ashleyxchen/echo-project/README.md

# echo-project

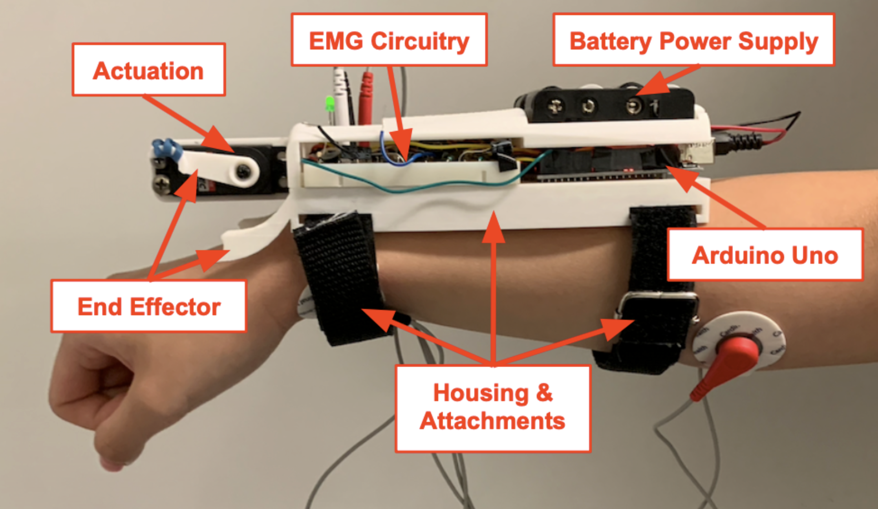
[picture p1: Figures and Tables/IMG_1434.png]

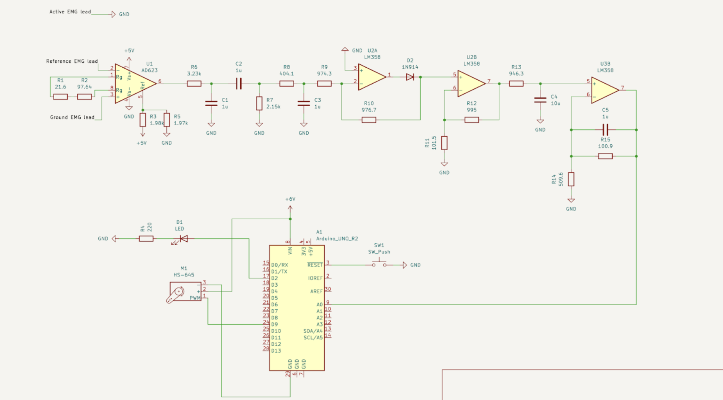
[picture p2: Figures and Tables/IMG_4543.png]

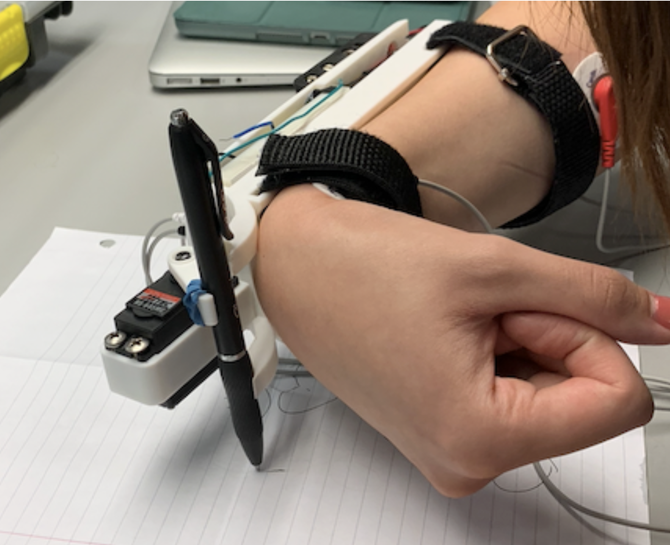
[picture p3: Figures and Tables/IMG_5352.png]

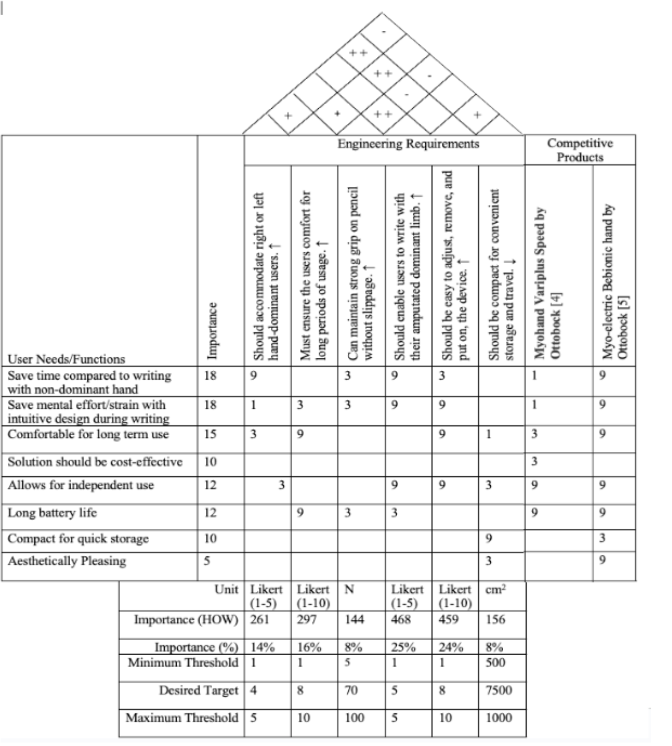
[picture p4: Figures and Tables/IMG_9596.png]
